mhqb365/fan-uv-mod/schematic.pdf

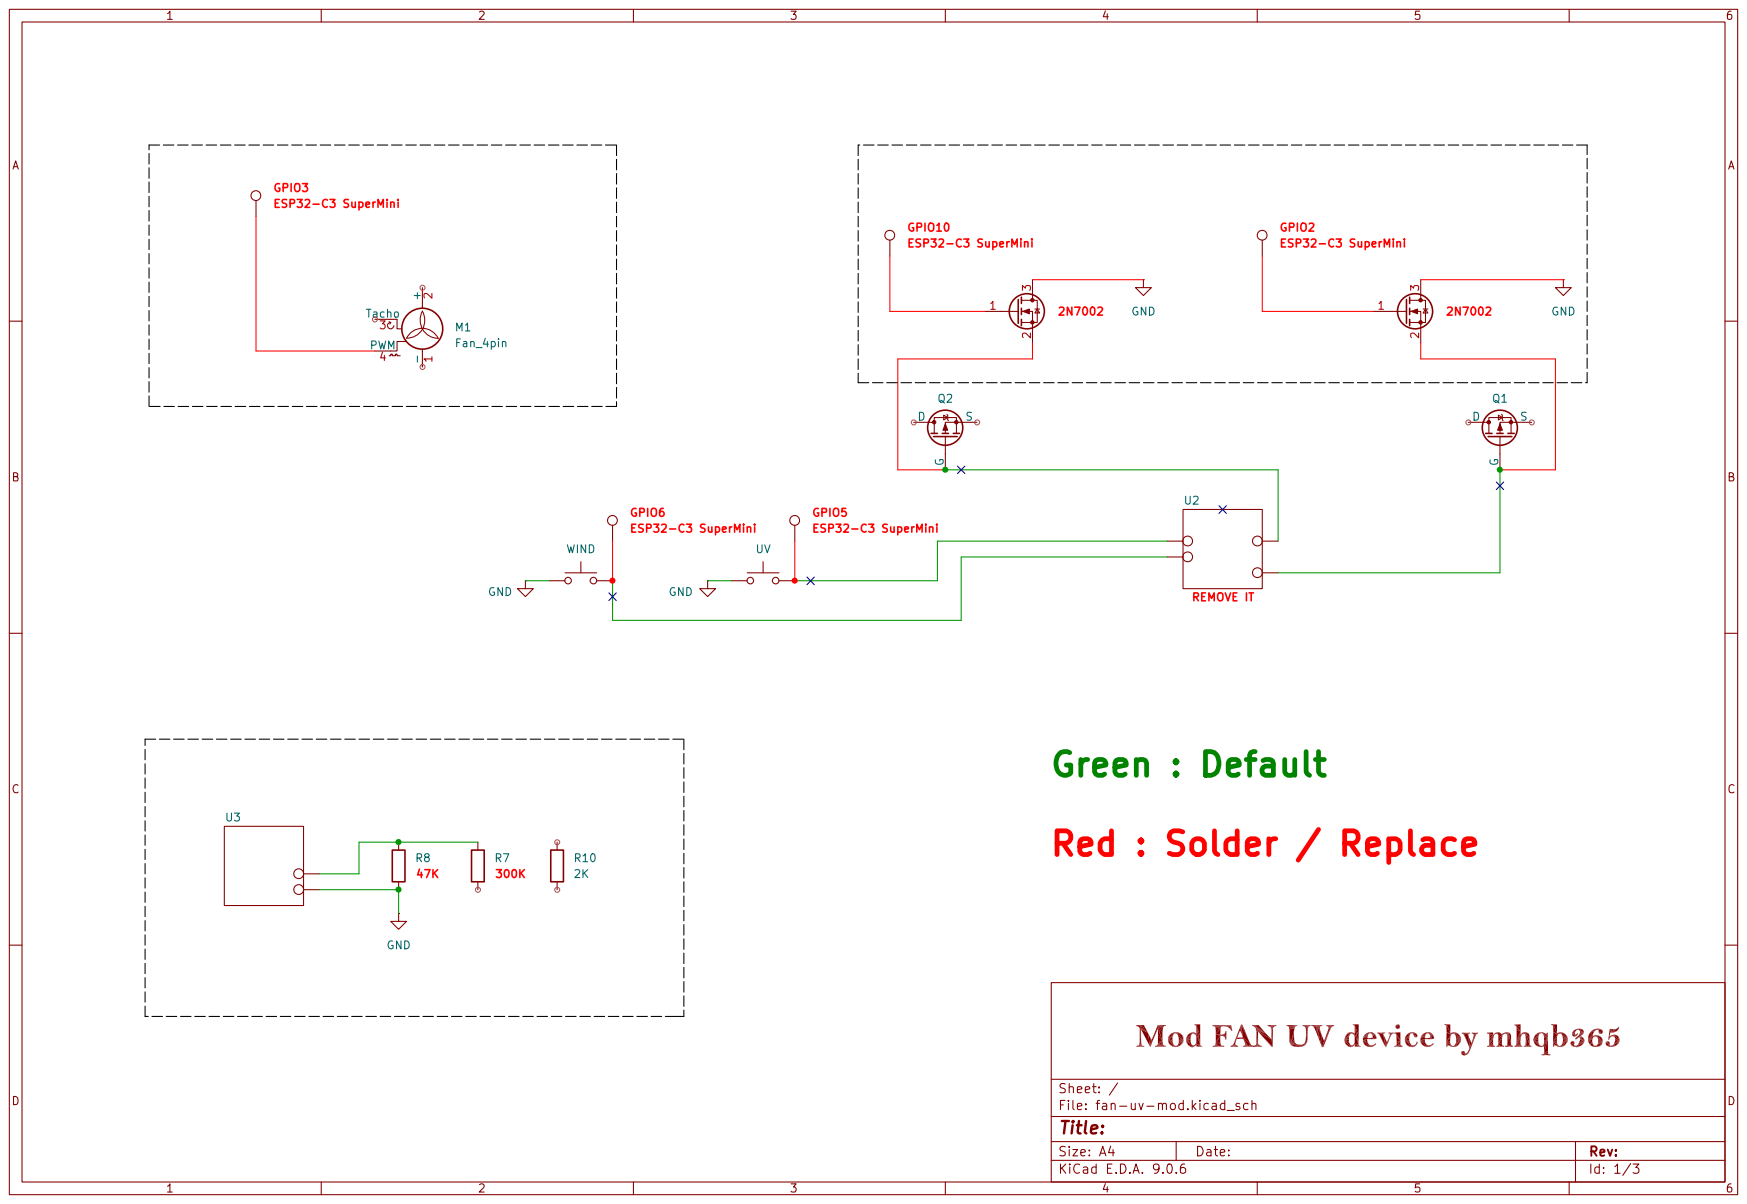
[picture p5: page 1]
