mhqb365/fan-uv-mod/schematic/fan-uv-mod.kicad_sch

## KiCad design schematic/fan-uv-mod.kicad_sch (2025-12-07)

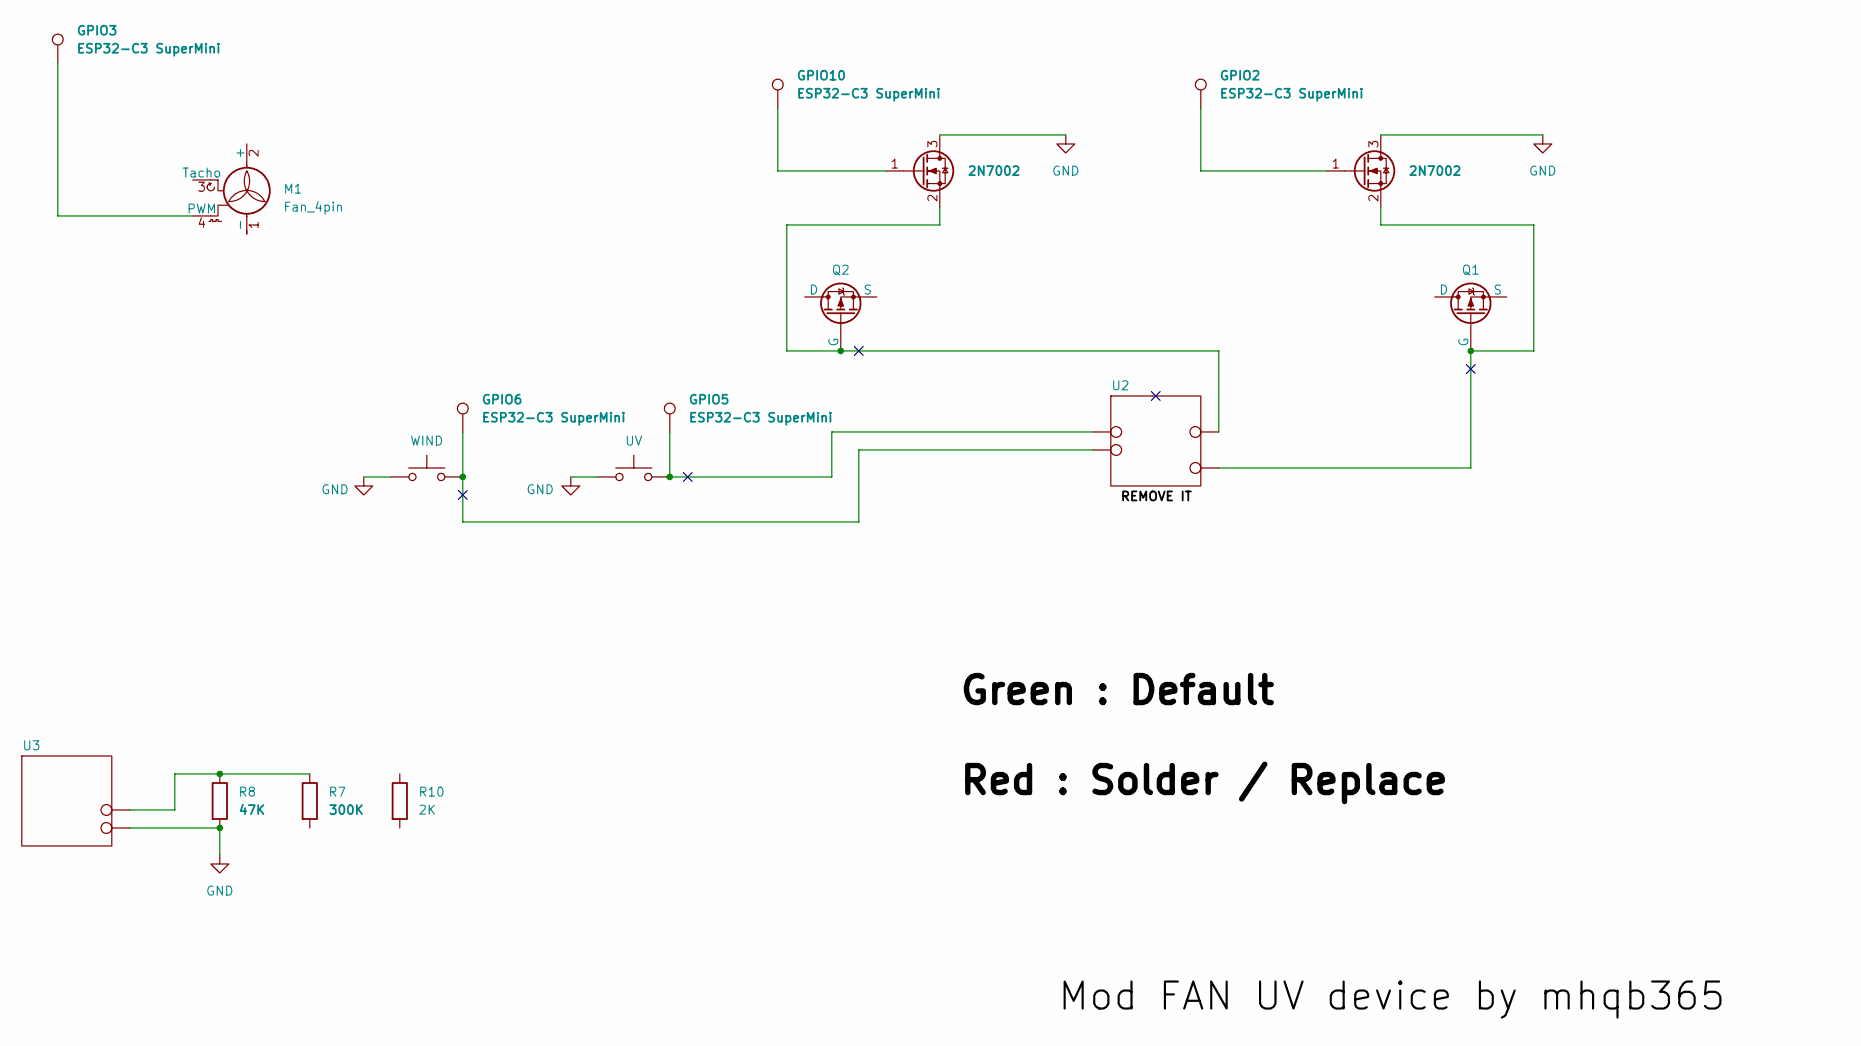
[picture p6: schematic fan-uv-mod.kicad_sch]

Parts:
GPIO2, GPIO3, GPIO5, GPIO6, GPIO10: ESP32-C3 SuperMini
M1: Fan_4pin
Q1, Q2: PMOS
Q3, Q4: 2N7002; SOT-23
R7: 300K
R8: 47K
R10: 2K
SW1: WIND
SW2: UV
TP1, TP2, TP3, TP4, TP5, TP6: TestPoint

Connections:
GND: Q3.3 (D), Q4.3 (D), R8.2, SW1.1, SW2.1, TP5.1
unnamed: GPIO2.1, Q3.1 (G)
unnamed: GPIO3.1, M1.4 (PWM)
unnamed: GPIO5.1, SW2.2, TP3.1
unnamed: GPIO6.1, SW1.2, TP4.1
unnamed: GPIO10.1, Q4.1 (G)
unnamed: Q1.2 (G), Q3.2 (S), TP2.1
unnamed: Q2.2 (G), Q4.2 (S), TP1.1
unnamed: R7.1, R8.1, TP6.1
